jroorda/edison-light-replacement/README.md

edison-light-replacement
========================

Design files and instructions for a replacement LED board for USB Edison bulbs.

All PCB files were created in Eagle version 7.0.0
