jroorda/edison-light-replacement/Part List.xlsx

White LED Board Parts List
Designation | PN | Vendor | Desc.
PCB | 2.0-W | Oshpark | custom PCB with single LED
LED | LTW-Z5630SZL50 | Digikey | White 5000K PLCC 5.6 x 3 mm LED
Resistor | 667-ERJ-8ENF16R9V | Mouser | 17 Ohm, 1206 Resistor
JST Jack | PTR-08612 | Sparkfun | JST 2, SMD Jack
JST Cable Assy | PRT-09914 | Sparkfun | JST 2 Cable Assembly
Color LED Board Parts List
Designation | PN | Vendor
PCB | 1.0-C | Oshpark | custom PCB with dual LEDs
JST Jack | PTR-08612 | Sparkfun | JST 2, SMD Jack
JST Cable Assy | PRT-09914 | Sparkfun | JST 2 Cable Assembly
Mix and match 2 of the following LED options. For each LED use the associated resistor
LED RED | 720-LRT68FU1AA11Z | Mouser | RED LED, PLCC2
Resistor | 71-CRCW0805-150-E3 | Mouser | 150 Ohm, 805 Resistor
LED GREEN | 941-CLM1BGKWCVAXA7A3 | Mouser | RED LED, PLCC2
Resistor | 71-CRCW0805-97.6-E3 | Mouser | 97.6 Ohm, 805 Resistor
LED BLUE | 941-CLM1BBKWCTBUB453 | Mouser | RED LED, PLCC2
Resistor | 71-CRCW0805-97.6-E3 | Mouser | 97.6 Ohm, 805 Resistor
