jroorda/edison-light-replacement/PCB_Files/White/edisonLight.brd

## EAGLE design PCB_Files/White/edisonLight.brd (2014-11-24)

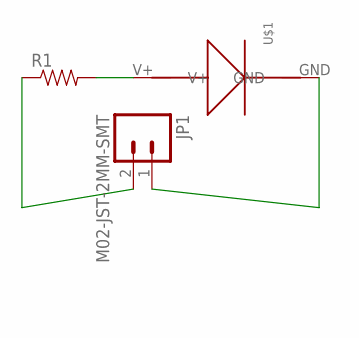
[picture p1: schematic edisonLight.sch]

Parts:
JP1: M02-JST-2MM-SMT; JST-2-SMD
R1: RESISTOR2010; R2010
U$1: MYLEDDEV; LTW-Z5630LED

Connections:
unnamed: R1.2, U$1.V+
unnamed: JP1.1 (2), U$1.GND
unnamed: JP1.2 (1), R1.1

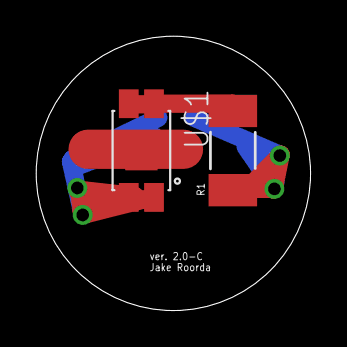
[picture p2: board edisonLight.brd from above]

Board: 2 copper layers, 15.2 x 15.2 mm, 3 parts (1 on the bottom side), 3 nets.
