jroorda/edison-light-replacement/PCB_Files/Color/edisonLightColor.brd

## EAGLE design PCB_Files/Color/edisonLightColor.brd (2014-11-24)

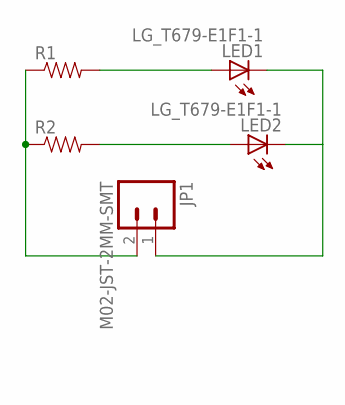
[picture p3: schematic edisonLightColor.sch]

Parts:
JP1: M02-JST-2MM-SMT; JST-2-SMD
LED1, LED2: LG_T679-E1F1-1; PLCC2
R1, R2: RESISTOR0805-RES; 0805

Connections:
unnamed: LED2.A, R2.2
unnamed: JP1.1 (2), LED1.C, LED2.C
unnamed: JP1.2 (1), R1.1, R2.1
unnamed: LED1.A, R1.2

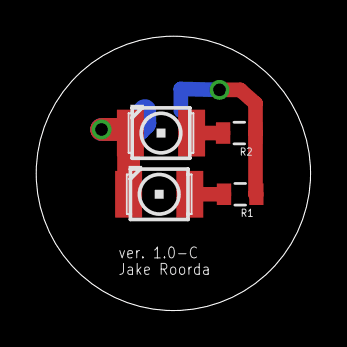
[picture p4: board edisonLightColor.brd from above]

Board: 2 copper layers, 15.2 x 15.2 mm, 5 parts (1 on the bottom side), 4 nets.
