jroorda/edison-light-replacement/(commit log)

2014-11-24 Added PCB FIles
    [edisonLight.brd, edisonLight.sch, edisonLightColor.brd, edisonLightColor.sch]
2014-11-24 Added Parts List
    [Part List.xlsx]
2014-12-07 Added PCB Assembly Pictures
2014-12-12 Completed Assembly Instructions
